salieff/jjrpulser/html/water_hot.png

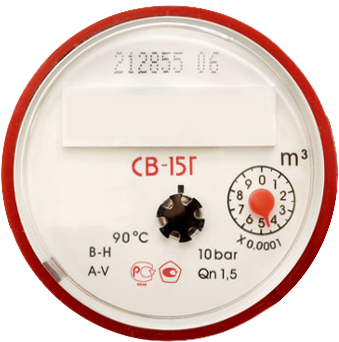
html/water_hot.png
