salieff/jjrpulser/Yozhik/RC522-1.jpg

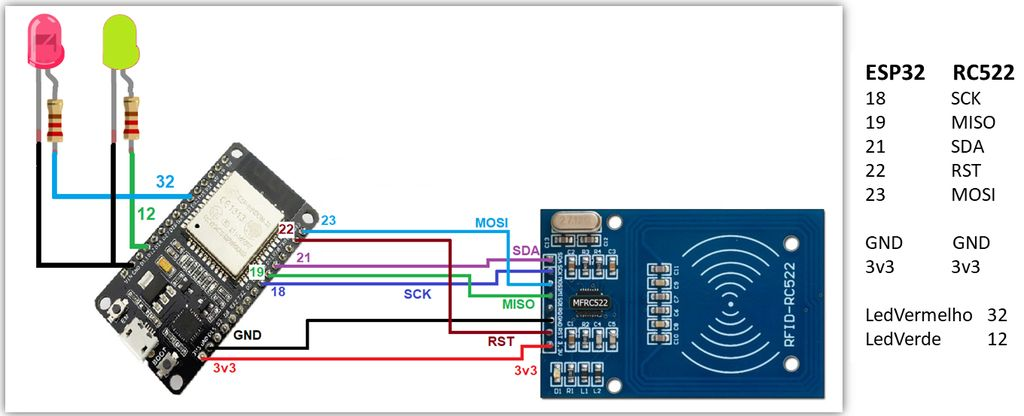
Yozhik/RC522-1.jpg
