salieff/jjrpulser/html/water_cold.png

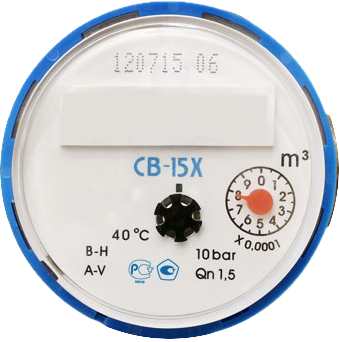
html/water_cold.png
