salieff/jjrpulser/Yozhik/esp32_wroom_esp32.png

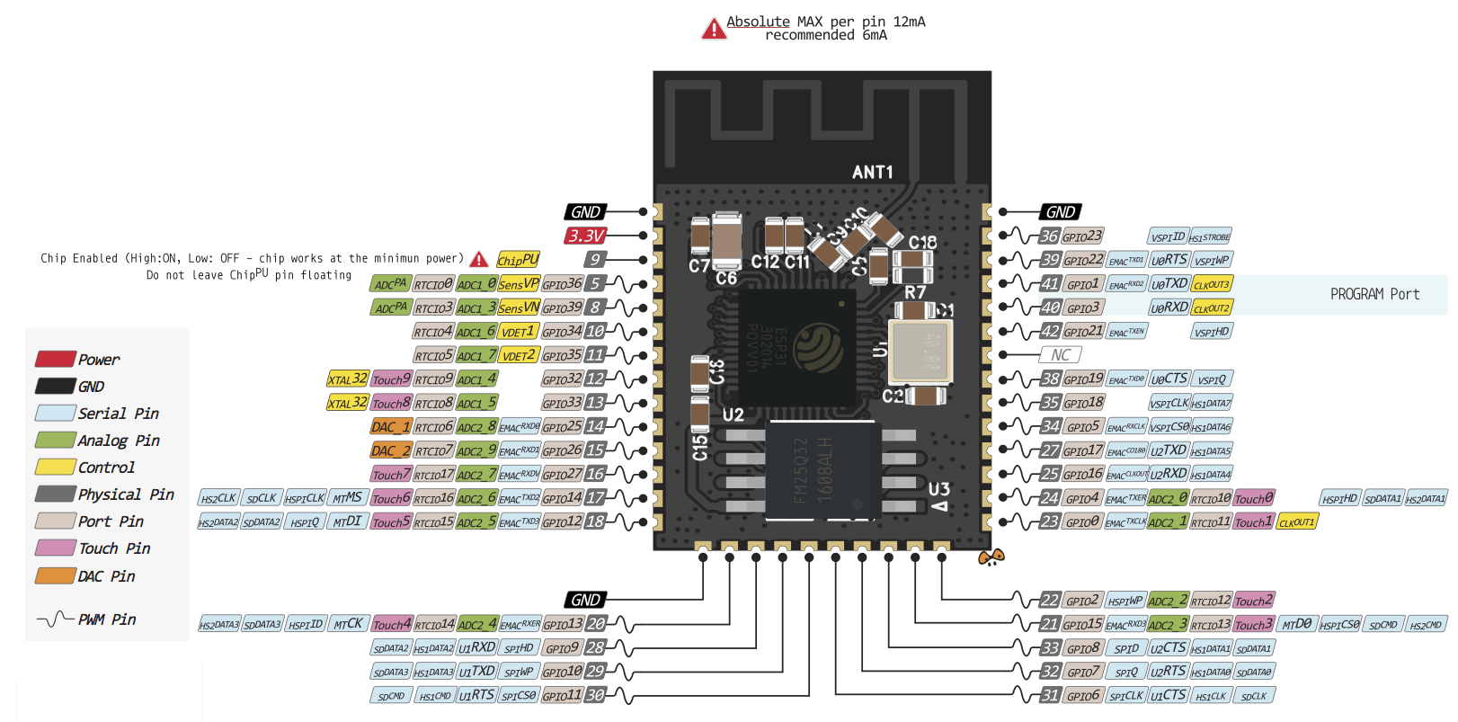
Yozhik/esp32_wroom_esp32.png
