salieff/jjrpulser/kicad-2/jjrpulser.kicad_pcb

## KiCad design kicad-2/jjrpulser.kicad_pcb (2019-07-10)

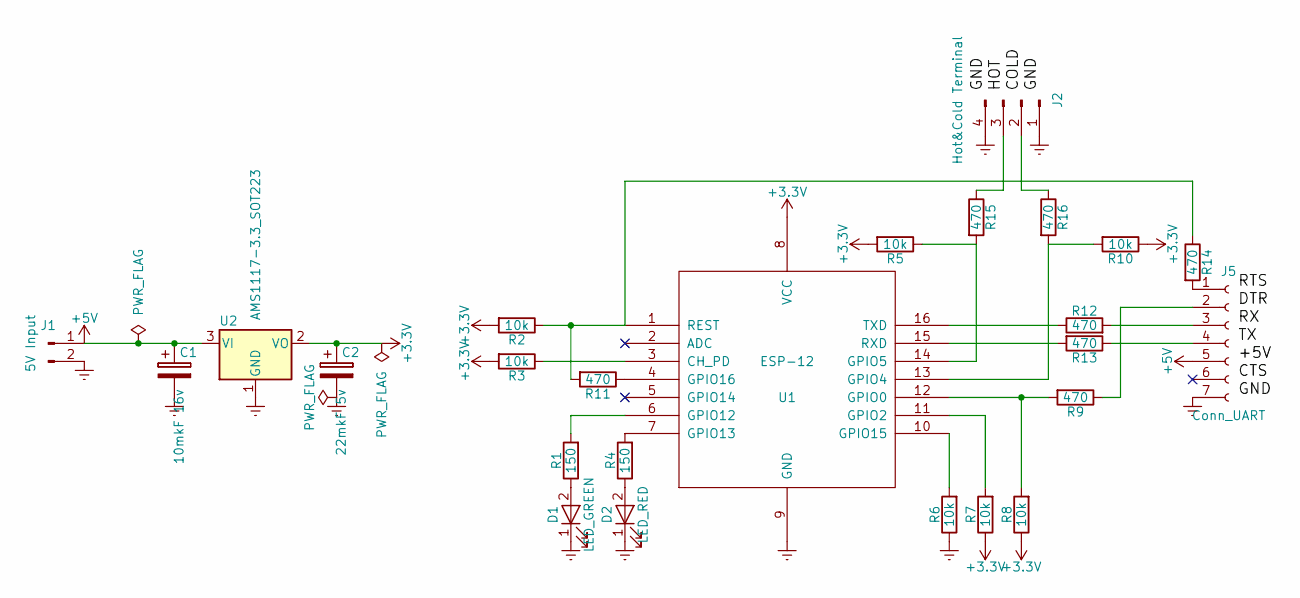
[picture p14: schematic jjrpulser.sch]

Parts:
C1: 10mkF 16v; CP_Tantalum_Case-A_EIA-3216-18_Reflow
C2: 22mkF 5v; CP_Tantalum_Case-A_EIA-3216-18_Reflow
D1: LED_GREEN; LED_D3.0mm
D2: LED_RED; LED_D3.0mm
J1: 5V Input; JST_PH_S2B-PH-K_02x2.00mm_Angled
J2: Hot&Cold Terminal; JST_PH_S4B-PH-K_04x2.00mm_Angled
J5: Conn_UART; Socket_Strip_Angled_1x07_Pitch2.54mm
R1, R4: 150; R_0805_HandSoldering
R2, R3, R6, R7, R8: 10k; R_0805_HandSoldering
R5, R10: 10k; R_1206_HandSoldering
R9, R11, R12, R13, R14, R15, R16: 470; R_0805_HandSoldering
U1: ESP-12
U2: AMS1117-3.3_SOT223; SOT-223-3Lead_TabPin2

Connections:
+3V3: C2.1, R2.2, R3.2, R5.2, R7.1, R8.1, R10.1, U1.8 (VCC), U2.2 (VO)
+5V: C1.1, J1.1, J5.5, U2.3 (VI)
Earth: C1.2, C2.2, D1.1 (K), D2.1 (K), J1.2, J2.1, J2.4, J5.7, R6.1, U1.9 (GND), U2.1 (GND)
unnamed: D1.2 (A), R1.1
unnamed: D2.2 (A), R4.1
unnamed: J2.2, R16.1
unnamed: J2.3, R15.1
unnamed: J5.1, R14.2
unnamed: J5.2, R9.1
unnamed: J5.3, R12.2
unnamed: J5.4, R13.1
unnamed: R1.2, U1.6 (GPIO12)
unnamed: R3.1, U1.3 (CH_PD)
unnamed: R4.2, U1.7 (GPIO13)
unnamed: R6.2, U1.10 (GPIO15)
unnamed: R7.2, U1.11 (GPIO2)
unnamed: R8.2, R9.2, U1.12 (GPIO0)
unnamed: R10.2, R16.2, U1.13 (GPIO4)
unnamed: R11.1, U1.4 (GPIO16)
unnamed: R2.1, R11.2, R14.1, U1.1 (REST)
unnamed: R12.1, U1.16 (TXD)
unnamed: R13.2, U1.15 (RXD)
unnamed: R5.1, R15.2, U1.14 (GPIO5)

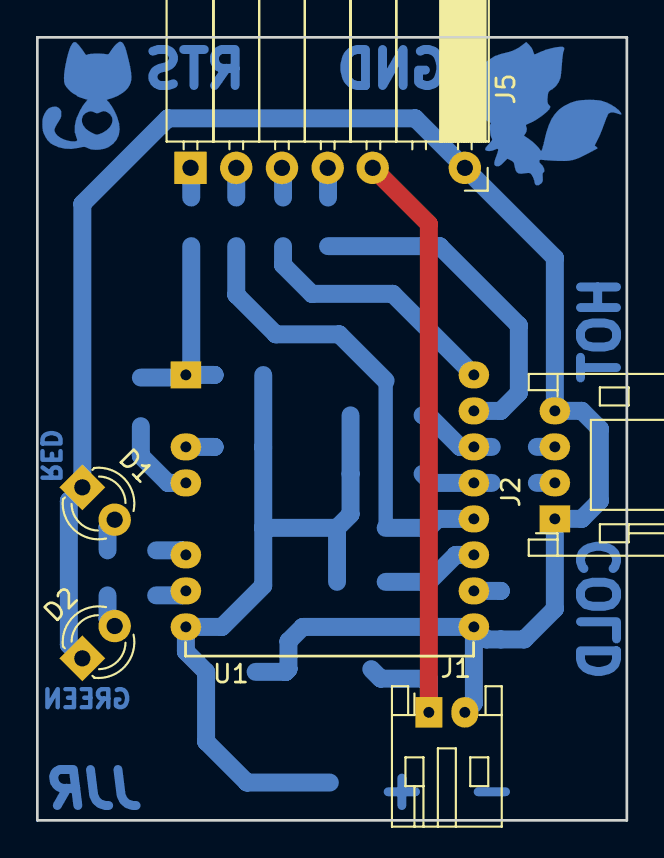
[picture p15: board jjrpulser.kicad_pcb from above]

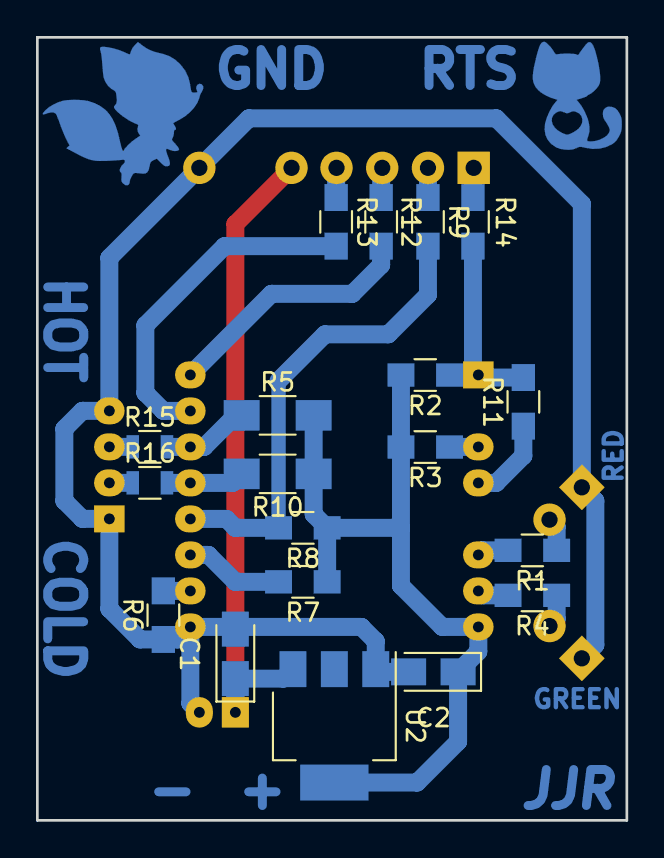
[picture p16: board jjrpulser.kicad_pcb from below]

Board: 2 copper layers, 32.8 x 43.5 mm, 27 parts (19 on the bottom side), 23 nets.

Other parts of the board:
Ref**: Val**; 1296354
Ref**#2: Val**; cute_kittens_vector_set
