salieff/jjrpulser/FSBrowser/FSBrowser.ino

/*
  FSWebServer - Example WebServer with SPIFFS backend for esp8266
  Copyright (c) 2015 Hristo Gochkov. All rights reserved.
  This file is part of the ESP8266WebServer library for Arduino environment.

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
  upload the contents of the data folder with MkSPIFFS Tool ("ESP8266 Sketch Data Upload" in Tools menu in Arduino IDE)
  or you can upload the contents of a folder if you CD in that folder and run the following command:
  for file in `\ls -A1`; do curl -F "file=@$PWD/$file" esp8266fs.local/edit; done

  access the sample web page at http://esp8266fs.local
  edit the page by going to http://esp8266fs.local/edit
*/

#include <ESP8266WiFi.h>
#include <WiFiClient.h>
#include <ESP8266WebServer.h>
#include <ESP8266mDNS.h>
#include <FS.h>

#include "passwords.h"
#include "blinker.h"
#include "cometserver.h"


FS* filesystem = &SPIFFS;

#define DBG_OUTPUT_PORT Serial

const char* ssid = STASSID;
const char* password = STAPSK;
const char* host = "esp8266fs";

ESP8266WebServer server(80);
CometServer cometServer(81);

//holds the current upload
File fsUploadFile;

void blinkerEvent(Blinker &blinker, Blinker::Mode, Blinker::Mode, void *)
{
    cometServer.postEvent("{\"command\": \"ledmode\", \"color\": \"" + blinker.name() + "\", \"mode\": \"" + blinker.modeName() +"\"}");
}

Blinker greenBlinker(GREEN_LED_PIN_NUMBER, "green", blinkerEvent);
Blinker redBlinker(RED_LED_PIN_NUMBER, "red", blinkerEvent);

//format bytes
String formatBytes(size_t bytes) {
    if (bytes < 1024) {
        return String(bytes) + "B";
    } else if (bytes < (1024 * 1024)) {
        return String(bytes / 1024.0) + "KB";
    } else if (bytes < (1024 * 1024 * 1024)) {
        return String(bytes / 1024.0 / 1024.0) + "MB";
    } else {
        return String(bytes / 1024.0 / 1024.0 / 1024.0) + "GB";
    }
}

String getContentType(String filename) {
    if (server.hasArg("download")) {
        return "application/octet-stream";
    } else if (filename.endsWith(".htm")) {
        return "text/html";
    } else if (filename.endsWith(".html")) {
        return "text/html";
    } else if (filename.endsWith(".css")) {
        return "text/css";
    } else if (filename.endsWith(".js")) {
        return "application/javascript";
    } else if (filename.endsWith(".png")) {
        return "image/png";
    } else if (filename.endsWith(".gif")) {
        return "image/gif";
    } else if (filename.endsWith(".jpg")) {
        return "image/jpeg";
    } else if (filename.endsWith(".ico")) {
        return "image/x-icon";
    } else if (filename.endsWith(".xml")) {
        return "text/xml";
    } else if (filename.endsWith(".pdf")) {
        return "application/x-pdf";
    } else if (filename.endsWith(".zip")) {
        return "application/x-zip";
    } else if (filename.endsWith(".gz")) {
        return "application/x-gzip";
    }
    return "text/plain";
}

bool handleFileRead(String path) {
    DBG_OUTPUT_PORT.println("handleFileRead: " + path);
    if (path.endsWith("/")) {
        path += "index.htm";

        blinkerEvent(greenBlinker, Blinker::MaxMode, Blinker::MaxMode, nullptr);
        blinkerEvent(redBlinker, Blinker::MaxMode, Blinker::MaxMode, nullptr);
    }
    String contentType = getContentType(path);
    String pathWithGz = path + ".gz";
    if (filesystem->exists(pathWithGz) || filesystem->exists(path)) {
        if (filesystem->exists(pathWithGz)) {
            path += ".gz";
        }
        File file = filesystem->open(path, "r");
        server.streamFile(file, contentType);
        file.close();
        return true;
    }
    return false;
}

void handleFileUpload() {
    if (server.uri() != "/edit") {
        return;
    }
    HTTPUpload& upload = server.upload();
    if (upload.status == UPLOAD_FILE_START) {
        String filename = upload.filename;
        if (!filename.startsWith("/")) {
            filename = "/" + filename;
        }
        DBG_OUTPUT_PORT.print("handleFileUpload Name: ");
        DBG_OUTPUT_PORT.println(filename);
        fsUploadFile = filesystem->open(filename, "w");
        filename = String();
    } else if (upload.status == UPLOAD_FILE_WRITE) {
        //DBG_OUTPUT_PORT.print("handleFileUpload Data: "); DBG_OUTPUT_PORT.println(upload.currentSize);
        if (fsUploadFile) {
            fsUploadFile.write(upload.buf, upload.currentSize);
        }
    } else if (upload.status == UPLOAD_FILE_END) {
        if (fsUploadFile) {
            fsUploadFile.close();
        }
        DBG_OUTPUT_PORT.print("handleFileUpload Size: ");
        DBG_OUTPUT_PORT.println(upload.totalSize);
    }
}

void handleFileDelete() {
    if (server.args() == 0) {
        return server.send(500, "text/plain", "BAD ARGS");
    }
    String path = server.arg(0);
    DBG_OUTPUT_PORT.println("handleFileDelete: " + path);
    if (path == "/") {
        return server.send(500, "text/plain", "BAD PATH");
    }
    if (!filesystem->exists(path)) {
        return server.send(404, "text/plain", "FileNotFound");
    }
    filesystem->remove(path);
    server.send(200, "text/plain", "");
    path = String();
}

void handleFileCreate() {
    if (server.args() == 0) {
        return server.send(500, "text/plain", "BAD ARGS");
    }
    String path = server.arg(0);
    DBG_OUTPUT_PORT.println("handleFileCreate: " + path);
    if (path == "/") {
        return server.send(500, "text/plain", "BAD PATH");
    }
    if (filesystem->exists(path)) {
        return server.send(500, "text/plain", "FILE EXISTS");
    }
    File file = filesystem->open(path, "w");
    if (file) {
        file.close();
    } else {
        return server.send(500, "text/plain", "CREATE FAILED");
    }
    server.send(200, "text/plain", "");
    path = String();
}

void handleFileList() {
    if (!server.hasArg("dir")) {
        server.send(500, "text/plain", "BAD ARGS");
        return;
    }

    String path = server.arg("dir");
    DBG_OUTPUT_PORT.println("handleFileList: " + path);
    Dir dir = filesystem->openDir(path);
    path = String();

    String output = "[";
    while (dir.next()) {
        File entry = dir.openFile("r");
        if (output != "[") {
            output += ',';
        }
        bool isDir = false;
        output += "{\"type\":\"";
        output += (isDir) ? "dir" : "file";
        output += "\",\"name\":\"";
        if (entry.name()[0] == '/') {
            output += &(entry.name()[1]);
        } else {
            output += entry.name();
        }
        output += "\"}";
        entry.close();
    }

    output += "]";
    server.send(200, "text/json", output);
}

Blinker & getBlinkerByName(String name)
{
    if (name == "green")
        return greenBlinker;

    return redBlinker;
}

void handleLEDMode() {
    if (!server.hasArg("color") || !server.hasArg("mode")) {
        server.send(500, "text/plain", "BAD ARGS");
        return;
    }

    getBlinkerByName(server.arg("color")).setMode(server.arg("mode"), true);
    DBG_OUTPUT_PORT.println(server.arg("color") + " = " + server.arg("mode"));

    server.send(200);
}

void setup(void) {
    DBG_OUTPUT_PORT.begin(115200);
    DBG_OUTPUT_PORT.print("\n");
    DBG_OUTPUT_PORT.setDebugOutput(true);
    filesystem->begin();
    {
        Dir dir = filesystem->openDir("/");
        while (dir.next()) {
            String fileName = dir.fileName();
            size_t fileSize = dir.fileSize();
            DBG_OUTPUT_PORT.printf("FS File: %s, size: %s\n", fileName.c_str(), formatBytes(fileSize).c_str());
        }
        DBG_OUTPUT_PORT.printf("\n");
    }


    //WIFI INIT
    WiFi.hostname(host);

    DBG_OUTPUT_PORT.printf("Connecting to %s\n", ssid);
    if (String(WiFi.SSID()) != String(ssid)) {
        WiFi.mode(WIFI_STA);
        WiFi.begin(ssid, password);
    }

    while (WiFi.status() != WL_CONNECTED) {
        delay(500);
        DBG_OUTPUT_PORT.print(".");
    }
    DBG_OUTPUT_PORT.println("");
    DBG_OUTPUT_PORT.print("Connected! IP address: ");
    DBG_OUTPUT_PORT.println(WiFi.localIP());

    MDNS.begin(host);
    DBG_OUTPUT_PORT.print("Open http://");
    DBG_OUTPUT_PORT.print(host);
    DBG_OUTPUT_PORT.println(".local/edit to see the file browser");


    //SERVER INIT
    //manage leds modes
    server.on("/ledmode", HTTP_GET, handleLEDMode);
    //list directory
    server.on("/list", HTTP_GET, handleFileList);
    //load editor
    server.on("/edit", HTTP_GET, []() {
        if (!handleFileRead("/edit.htm")) {
            server.send(404, "text/plain", "FileNotFound");
        }
    });
    //create file
    server.on("/edit", HTTP_PUT, handleFileCreate);
    //delete file
    server.on("/edit", HTTP_DELETE, handleFileDelete);
    //first callback is called after the request has ended with all parsed arguments
    //second callback handles file uploads at that location
    server.on("/edit", HTTP_POST, []() {
        server.send(200, "text/plain", "");
    }, handleFileUpload);

    //called when the url is not defined here
    //use it to load content from SPIFFS
    server.onNotFound([]() {
        if (!handleFileRead(server.uri())) {
            server.send(404, "text/plain", "FileNotFound");
        }
    });

    //get heap status, analog input value and all GPIO statuses in one json call
    server.on("/all", HTTP_GET, []() {
        String json = "{";
        json += "\"heap\":" + String(ESP.getFreeHeap());
        json += ", \"analog\":" + String(analogRead(A0));
        json += ", \"gpio\":" + String((uint32_t)(((GPI | GPO) & 0xFFFF) | ((GP16I & 0x01) << 16)));
        json += ", \"uptime\":" + String(millis());
        json += "}";
        server.send(200, "text/json", json);
        json = String();
    });
    server.begin();
    DBG_OUTPUT_PORT.println("HTTP server started");

    cometServer.setup();

    greenBlinker.setup();
    redBlinker.setup();

    greenBlinker.setMode(Blinker::Work);
    redBlinker.setMode(Blinker::Error);
}

void loop(void) {
    server.handleClient();
    MDNS.update();

    cometServer.work();

    greenBlinker.work();
    redBlinker.work();
}
