salieff/jjrpulser/jjrpulser/passwords.h

#ifndef JJR_PULSER_PASSWORDS_H
#define JJR_PULSER_PASSWORDS_H

#define JJR_PULSER_WIFI_SSID "My Wi-Fi network name"
#define JJR_PULSER_WIFI_PASSWORD "My Wi-Fi network password"

#define JJR_PULSER_SERVER      "server.my"
#define JJR_PULSER_SERVER_PORT 8080
#define JJR_PULSER_SERVER_URL  "/cgi-bin/myscript.ext"

#endif // JJR_PULSER_PASSWORDS_H
