salieff/jjrpulser/(commit log)

2018-10-26 Скорость консоли в 74880, чтобы было видно boot message. Режимы лампочек переключаются из консоли, зеленая - 01234 и красная - gasdf
2018-10-26 Простые примеры на нажатия кнопок (с дребезгом) и зажигание светодиодов.
2018-11-07 Начало реализации соединения с сервером
2018-11-08 Реализация соединения с Wi-Fi
2018-11-09 Асинхронная посылка импульсов на HTTP-сервер. Добавлены библиотеки ESPAsyncTCP и asyncHTTPrequest. Дефолтная стабилизация PinBouncer уменьшена до 500мс. Эмуляция hot и cold импульсов из консоли, клав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
2018-11-12 Вывод uptime по клавише u. Вывод free heap по клавише m. Нагрузочное тестирование - 3 запроса каждые 15 сек. Список параллельных HTTP-запросов. Рефакторинг, фиксы.
2018-11-13 Добавлено количество ошибок HTTP в статистику uptime. Реализация списка соединений, как статического массива (вместо вектора). Избавляемся от паттерна SingleTone в DataStorage. Избавляемся от STL. Не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
2018-11-16 Своя реализация HTTP GET, максимально простая и безглючная
2018-11-18 State-machine для TCP-соединения
2018-11-19 Доработка и отладка HTTPRequest. WIP
2018-11-20 Реализация парсинга HTTP
2018-11-20 Асинхронные HTTP/GET запросы дописаны до рабочего состояния. ESPAsyncTCP и asyncHTTPrequest удалены и заменены своей реализацией
2018-11-21 Маленькая адаптация под LWIP2
2018-11-22 Реализован setup со стороны сервера. Исправления.
    [httprequest.cpp, httprequest.h, jjrpulser.ino, storage.cpp, storage.h]
2018-11-23 Эксперименты и мелкие улучшения
2018-11-28 Серверная часть
2018-11-28 Поддержка отображения, хранения и передачи настроек в устройство
2018-11-28 Немного порядка
2018-12-07 Тотальный переход на MySQL. Рефакторинг.
2018-12-08 Новый тип графиков
2018-12-08 Наводим красоту
2018-12-09 Рефакторинг
2018-12-14 Защита от фальшивого setup при сбое базы. Наведение красоты.
2018-12-14 Сохранение показаний в EEPROM. Выключены лишние дебаги.
2018-12-21 Удалена забытая копипаста. Увеличены таймауты.
2018-12-24 Хранение setup для отправки в контроллер перенесено в файл для разгрузки БД. Timestamps и принудительный 0 по Y на графиках.
2018-12-24 Для ReadSetupCounters добавлен softmode, чтобы web-интерфейс не стирал при чтении setup, который сам же и записал.
2019-02-09 Распихали переменные по структурам. Подготовка к переезду статистики в storage.cpp и ее отправки на сервер
2019-03-11 Отсылка статистики на сервер. WIP
2019-03-12 Отсылка статистики на сервер. Рефакторинг
2019-03-25 Перенос сервера на NanoPi Fire3
2019-03-27 Бэкэнд для статистики. WIP.
2019-03-27 Отображение статистики на фронтэнде
2019-03-27 Утилита для нагрузочного тестирования сервера
2019-03-27 Наглядное дублирование статистики в ответе на запрос. Параллельные запросы в стресс-тесте.
2019-03-28 Фикс парсинга аптайма в начале суток. Запросы убраны из фона, потому что тогда счетчики не считаются.
2019-03-31 Улучшен запрос потребления по периодам
2019-04-02 Документация. Пример кронтаба
2019-04-03 Документация WIP
2019-04-13 Документация W.I.P
2019-04-13 Документация. Глава про blinker.cpp
2019-04-17 PDF para leer comodo
2019-04-19 Документация: глава про PinBouncer
2019-05-06 Документация WIP. Схемотехника для Kicad.
    [jjrpulser.kicad_pcb, jjrpulser.sch]
2019-05-08 Расстояние между ножками блока питания уменьшено до 47мм
    [jjrpulser.kicad_pcb]
2019-05-08 Мелкие улучшения трассировки
    [jjrpulser.kicad_pcb]
2019-05-09 Еще немного гламура в трассировку
    [jjrpulser.kicad_pcb]
2019-05-20 Документация. Описаны макросы, внутренние переменные и блок EEPROM-функций для модуля DataStorage
2019-05-24 Документация по модулю DataStorage. Описаны функции-обрабочики Wi-FI, функции работы с HTTP-запросами и со статистикой
2019-06-11 Более плотная разводка
    [jjrpulser-2.kicad_pcb]
2019-06-13 Оптимизированная разводка с интегрированным питанием
    [jjrpulser.kicad_pcb, jjrpulser.sch]
2019-06-14 Разводка в процессе
    [jjrpulser.kicad_pcb, jjrpulser.sch]
2019-06-17 Новая разводка: замена micro-USB на обычный разъем питания
    [jjrpulser.kicad_pcb, jjrpulser.sch]
2019-06-17 Новая разводка - WIP
    [jjrpulser.kicad_pcb]
2019-06-18 Разводка2: +5V с UART - программирование и консоль без внешнего питания. GPIO16 <--> RESET - выход из deep sleep
    [jjrpulser.kicad_pcb, jjrpulser.sch]
2019-06-19 Разводка2: Забытые упоминания R2010 заменены на R1206
    [jjrpulser.sch]
2019-06-21 Новая разводка
    [jjrpulser.kicad_pcb, jjrpulser.sch]
2019-06-21 Разводка2: Защитные резисторы на подключении водосчетчиков
    [jjrpulser.kicad_pcb, jjrpulser.sch]
2019-06-22 Демонстрационный скетч с ШИМ на OUTPUT GPIO
2019-06-28 Новые маленькие коннекторы для счетчиков и питания
    [jjrpulser.kicad_pcb, jjrpulser.sch]
2019-07-02 Новая разводка. Котик и лисичка.
    [jjrpulser.kicad_pcb]
2019-07-10 Новая разводка: буквы и размеры
    [jjrpulser.kicad_pcb]
2019-12-19 Glue frontend and backend together
2019-12-29 Забытые файлы
2019-12-30 Рабочая реалиация COMET на long poll-ах
2020-03-13 Files for new ESP32 project
2020-03-14 Подавление избыточных COMET-событий экономит трафик
2020-03-15 Touch buttons added
